hoglet67/TangNano20KDock/PiGPIO40.png

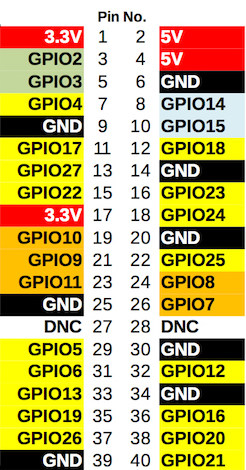
PiGPIO40.png
