hoglet67/TangNano20KDock/v1/tangnano20k_dock.pdf

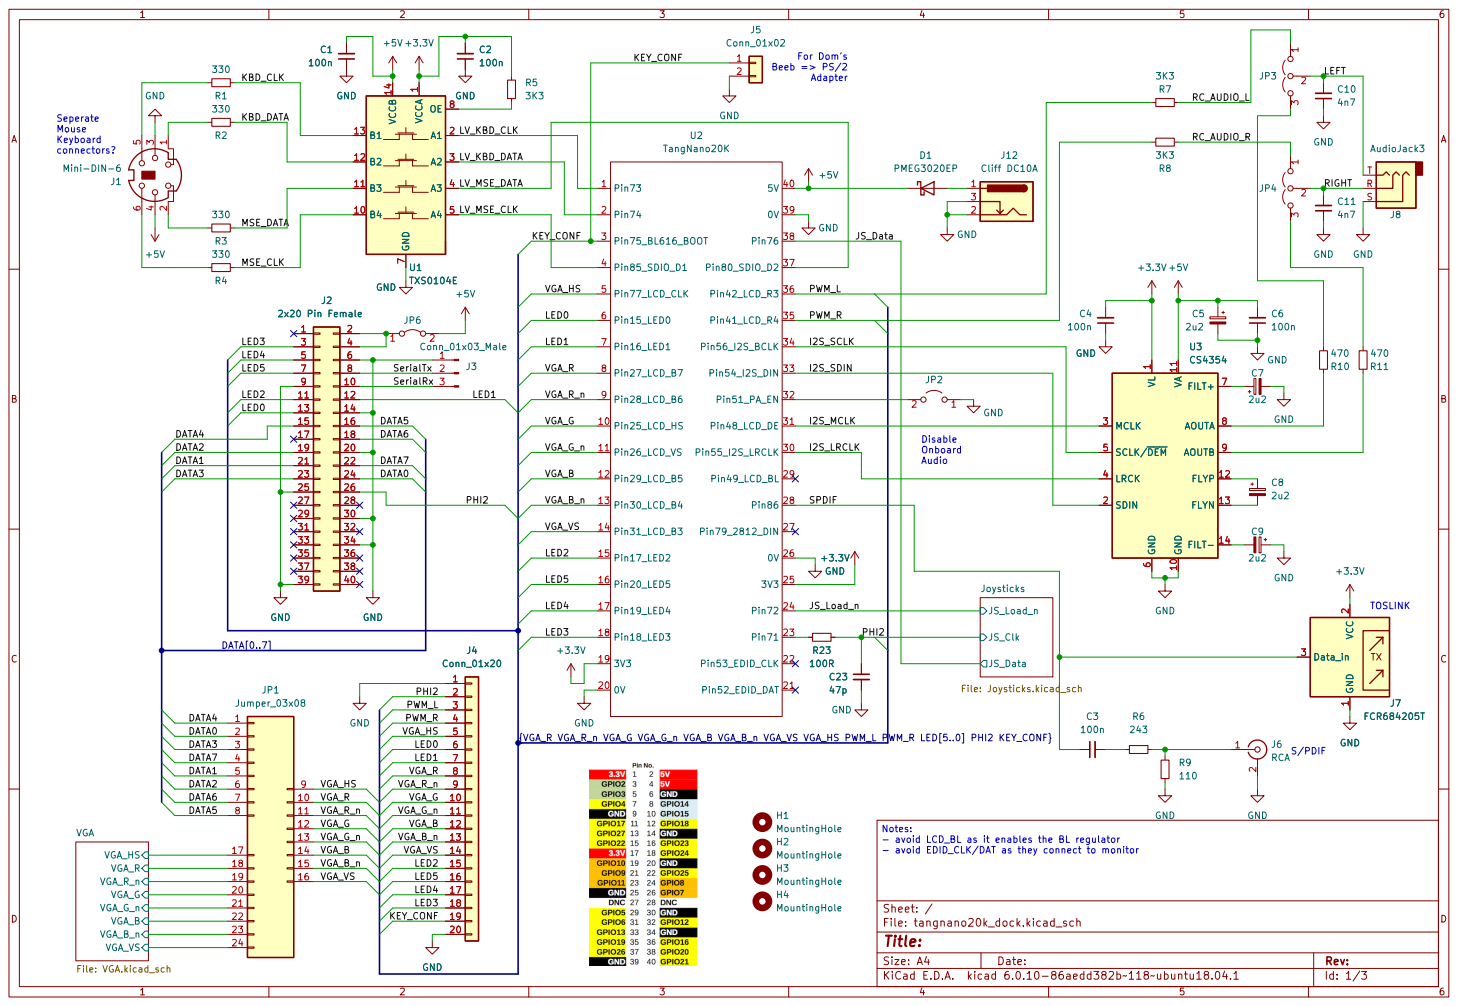
[picture p2: page 1]

For Dom's Beeb => PS/2 Adapter GND

I2S_SCLK

I2S_SDIN

1 GND 10 VA 11 FLYP 12 FLYN 13 FILT- 14 SDIN 2 MCLK 3

6 FILT+ 7 AOUTA 8 AOUTB 9 +3.3V GND

VGA_R_n VGA_B 12 VGA_G | 12 12
11 | 11 11
13 VGA_G_n | LED2 VGA_B VGA_B_n 13 13

18 | 15 VGA_B_n VGA_VS | 15 15
19 | 16 | 16 16
20 | | LED4 17 17

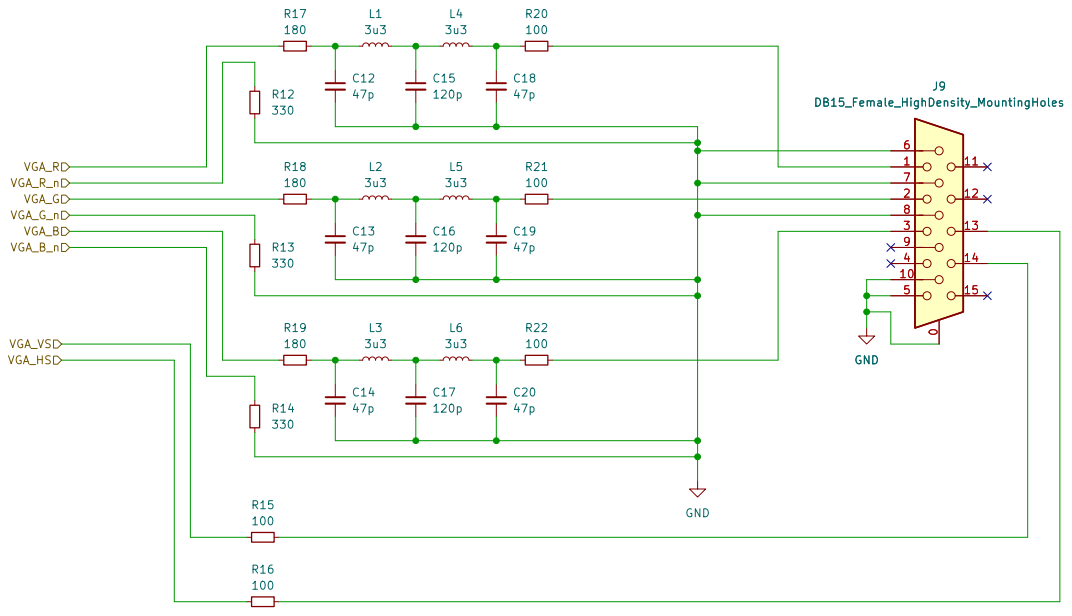
[picture p3: page 2]

File: VGA.kicad_sch Sheet: /VGA/
Id: 2/3 Title:

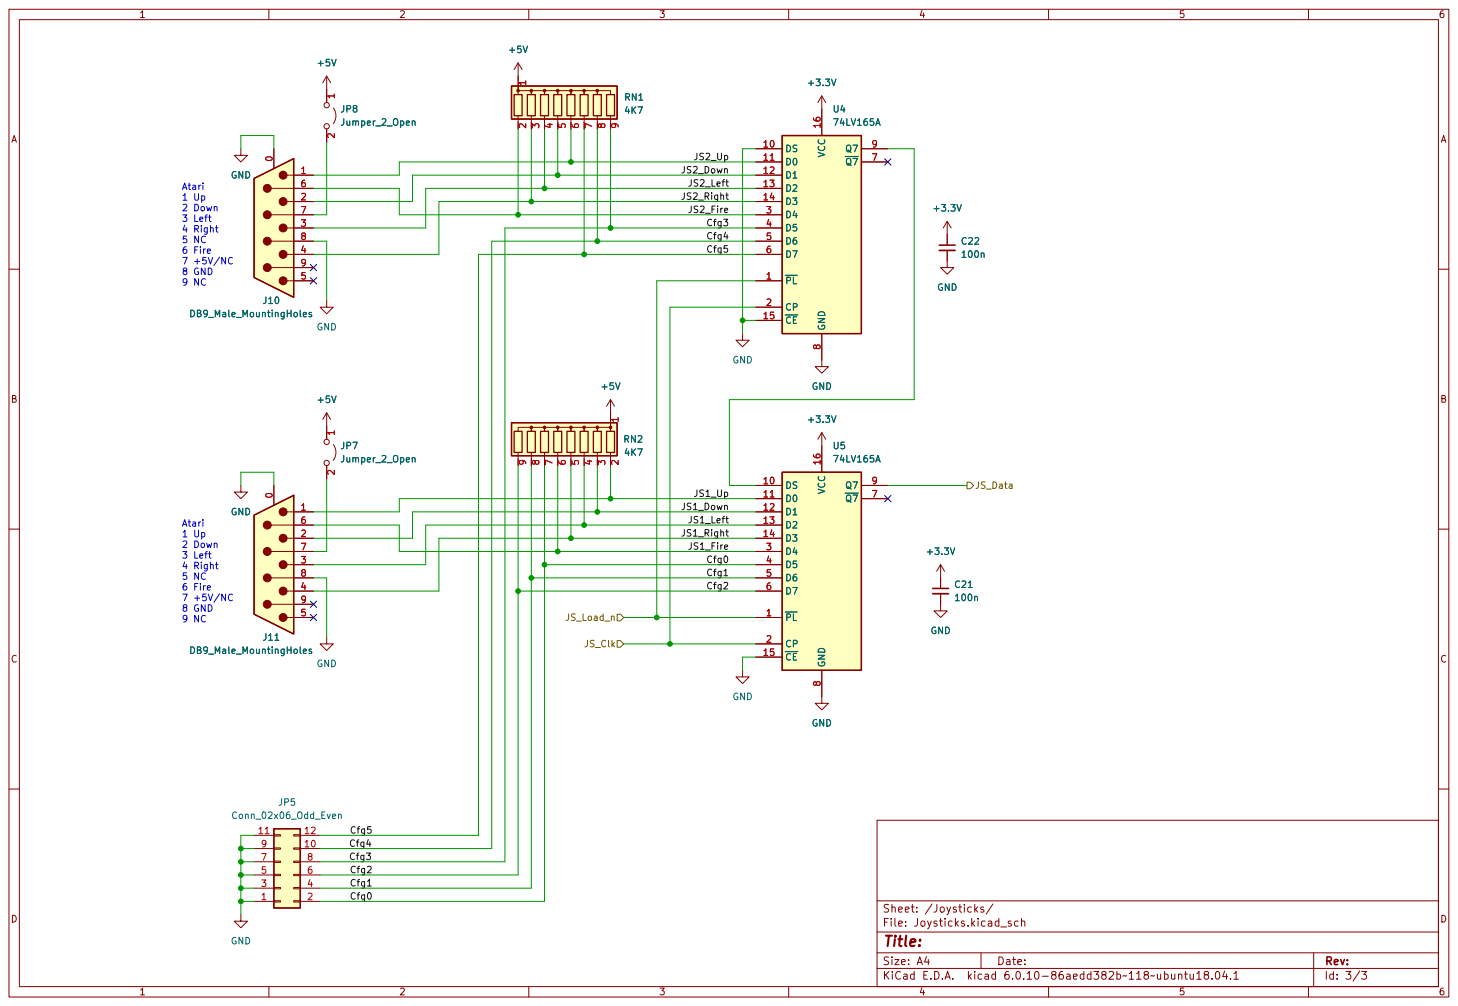
[picture p4: page 3]

JS1_Fire Atari 1 Up

Cfg0
Cfg1
