hoglet67/TangNano20KDock/v1/tangnano20k_dock.kicad_pcb

## KiCad design v1/tangnano20k_dock.kicad_pcb (2025-05-01)

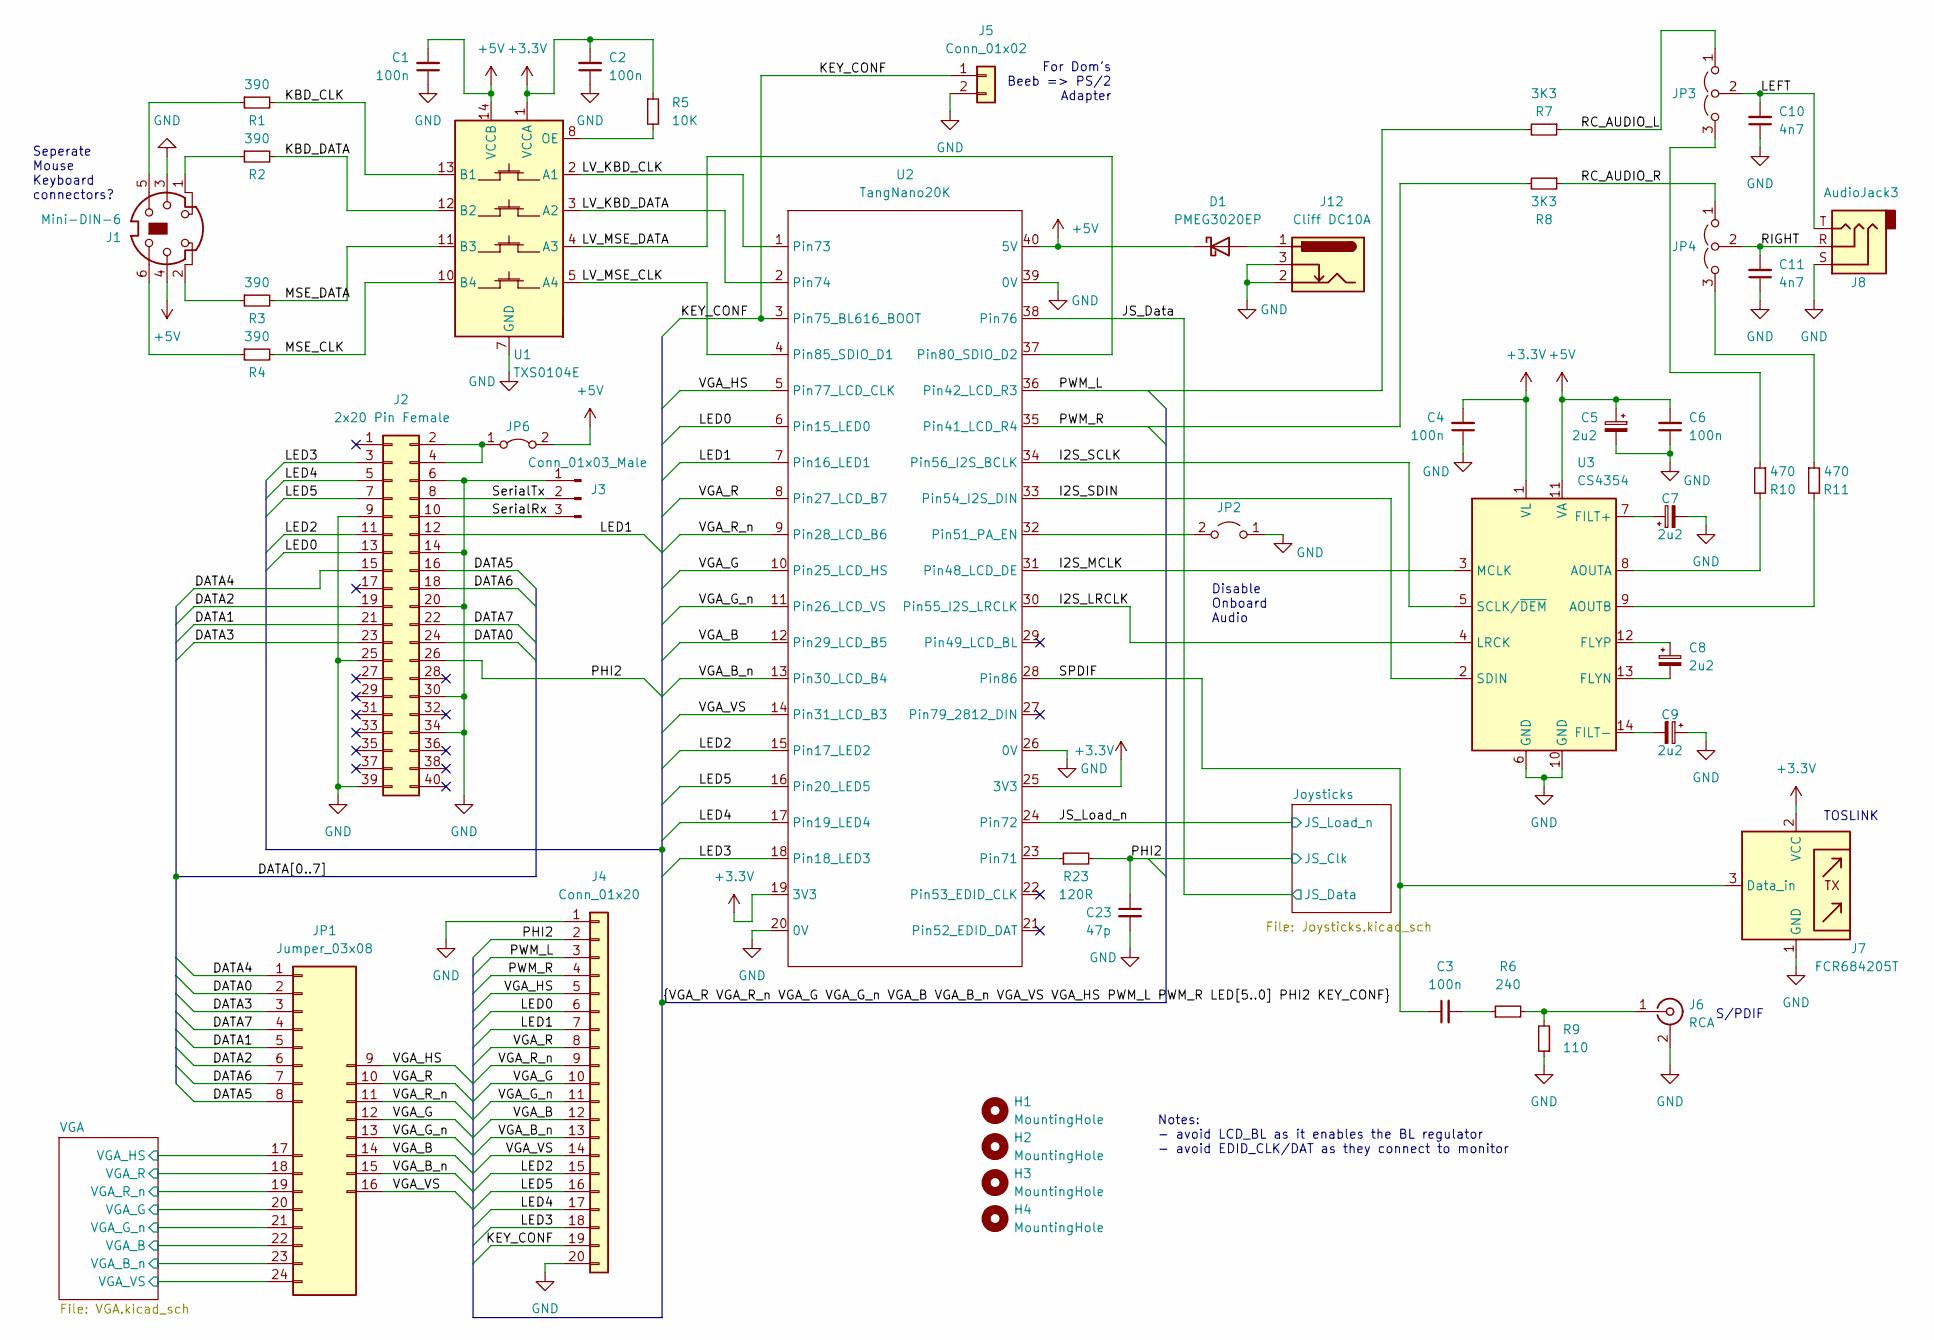
[picture p5: schematic tangnano20k_dock.kicad_sch]

Parts:
C1, C2, C3, C4, C6: 100n; C_1206_3216Metric_Pad1.33x1.80mm_HandSolder
C5, C7, C8, C9: 2u2; C_1206_3216Metric_Pad1.33x1.80mm_HandSolder
C10, C11: 4n7; C_1206_3216Metric_Pad1.33x1.80mm_HandSolder
C23: 47p; C_1206_3216Metric_Pad1.33x1.80mm_HandSolder
D1: PMEG3020EP; D_SOD-128
H1, H2, H3, H4: MountingHole; MountingHole_3.2mm_M3
J1: Mini-DIN-6; minidin6
J2: 2x20 Pin Female; Raspberry_Pi_Zero_Socketed_THT_FaceDown_MountingHoles
J3: Conn_01x03_Male; PinHeader_1x03_P2.54mm_Vertical
J4: Conn_01x20; PinHeader_1x20_P2.54mm_Vertical
J5: Conn_01x02; PinHeader_1x02_P2.54mm_Vertical
J6: RCA; phono
J7: FCR684205T
J8: AudioJack3; Jack_3.5mm_CUI_SJ1-3523N_Horizontal
J12: Cliff DC10A; CLIFF_FC68148_DC10A
JP1: Jumper_03x08; PinHeader_3x08_P2.54mm_Vertical
JP2: Jumper_2_Open; PinHeader_1x02_P2.54mm_Vertical
JP3, JP4: Jumper_3_Open; PinHeader_1x03_P2.54mm_Vertical
JP6: Jumper_2_Bridged; PinHeader_1x02_P2.54mm_Vertical
R1, R2, R3, R4: 390; R_1206_3216Metric_Pad1.30x1.75mm_HandSolder
R5: 10K; R_1206_3216Metric_Pad1.30x1.75mm_HandSolder
R6: 240; R_1206_3216Metric_Pad1.30x1.75mm_HandSolder
R7, R8: 3K3; R_1206_3216Metric_Pad1.30x1.75mm_HandSolder
R9: 110; R_1206_3216Metric_Pad1.30x1.75mm_HandSolder
R10, R11: 470; R_1206_3216Metric_Pad1.30x1.75mm_HandSolder
R23: 120R; R_1206_3216Metric_Pad1.30x1.75mm_HandSolder
U1: TXS0104E; SOIC-14_3.9x8.7mm_P1.27mm
U2: TangNano20K; TangNano20k
U3: CS4354; SOIC-14_3.9x8.7mm_P1.27mm

Connections:
+3.3V: C2.2, C4.2, J7.2 (VCC), R5.1, U1.1 (VCCA), U2.19 (3V3), U2.25 (3V3), U3.1 (VL); also elsewhere on the board
+5V: C1.2, C5.1, C6.2, D1.1 (K), J1.4, JP6.2 (B), U1.14 (VCCB), U2.40 (5V), U3.11 (VA); also elsewhere on the board
/DATA0: J2.24, JP1.2
/DATA1: J2.21, JP1.5
/DATA2: J2.19, JP1.6
/DATA3: J2.23, JP1.3
/DATA4: J2.15, JP1.1
/DATA5: J2.16, JP1.8
/DATA6: J2.18, JP1.7
/DATA7: J2.22, JP1.4
/I2S_LRCLK: U2.30 (Pin55_I2S_LRCLK), U3.4 (LRCK)
/I2S_MCLK: U2.31 (Pin48_LCD_DE), U3.3 (MCLK)
/I2S_SCLK: U2.34 (Pin56_I2S_BCLK), U3.5 (SCLK/~DEM)
/I2S_SDIN: U2.33 (Pin54_I2S_DIN), U3.2 (SDIN)
/JS_Data: U2.38 (Pin76); also elsewhere on the board
/JS_Load_n: U2.24 (Pin72); also elsewhere on the board
/KBD_CLK: R1.2, U1.13 (B1)
/KBD_DATA: R2.2, U1.12 (B2)
/KEY_CONF: J4.19, J5.1, U2.3 (Pin75_BL616_BOOT)
/LED0: J2.13, J4.6, U2.6 (Pin15_LED0)
/LED1: J2.12, J4.7, U2.7 (Pin16_LED1)
/LED2: J2.11, J4.15, U2.15 (Pin17_LED2)
/LED3: J2.3, J4.18, U2.18 (Pin18_LED3)
/LED4: J2.5, J4.17, U2.17 (Pin19_LED4)
/LED5: J2.7, J4.16, U2.16 (Pin20_LED5)
/LEFT: C10.2, J8.T, JP3.2 (C)
/LV_KBD_CLK: U1.2 (A1), U2.1 (Pin73)
/LV_KBD_DATA: U1.3 (A2), U2.2 (Pin74)
/LV_MSE_CLK: U1.5 (A4), U2.4 (Pin85_SDIO_D1)
/LV_MSE_DATA: U1.4 (A3), U2.37 (Pin80_SDIO_D2)
/MSE_CLK: R4.2, U1.10 (B4)
/MSE_DATA: R3.2, U1.11 (B3)
/PHI2: C23.1, J2.26, J4.2, R23.2; also elsewhere on the board
/PWM_L: J4.3, R7.2, U2.36 (Pin42_LCD_R3)
/PWM_R: J4.4, R8.2, U2.35 (Pin41_LCD_R4)
/RC_AUDIO_L: JP3.1 (A), R7.1
/RC_AUDIO_R: JP4.1 (A), R8.1
/RIGHT: C11.2, J8.R, JP4.2 (C)
/SPDIF: C3.1, J7.3 (Data_in), U2.28 (Pin86)
/SerialRx: J2.10, J3.3
/SerialTx: J2.8, J3.2
/VGA/VGA_B: JP1.22; also elsewhere on the board
/VGA/VGA_B_n: JP1.23; also elsewhere on the board
/VGA/VGA_G: JP1.20; also elsewhere on the board
/VGA/VGA_G_n: JP1.21; also elsewhere on the board
/VGA/VGA_HS: JP1.17; also elsewhere on the board
/VGA/VGA_R: JP1.18; also elsewhere on the board
/VGA/VGA_R_n: JP1.19; also elsewhere on the board
/VGA/VGA_VS: JP1.24; also elsewhere on the board
/VGA_B: J4.12, JP1.14, U2.12 (Pin29_LCD_B5)
/VGA_B_n: J4.13, JP1.15, U2.13 (Pin30_LCD_B4)
/VGA_G: J4.10, JP1.12, U2.10 (Pin25_LCD_HS)
/VGA_G_n: J4.11, JP1.13, U2.11 (Pin26_LCD_VS)
/VGA_HS: J4.5, JP1.9, U2.5 (Pin77_LCD_CLK)
/VGA_R: J4.8, JP1.10, U2.8 (Pin27_LCD_B7)
/VGA_R_n: J4.9, JP1.11, U2.9 (Pin28_LCD_B6)
/VGA_VS: J4.14, JP1.16, U2.14 (Pin31_LCD_B3)
GND: C1.1, C2.1, C4.1, C5.2, C6.1, C7.2, C9.1, C10.1, C11.1, C23.2, J1.3, J2.6, J2.9, J2.14, J2.20, J2.25, J2.30, J2.34, J2.39, J3.1, J4.1, J4.20, J5.2, J6.2 (Ext), J7.1 (GND), J8.S, J12.2, J12.3, JP2.1 (A), R9.1, U1.7 (GND), U2.20 (0V), U2.26 (0V), U2.39 (0V), U3.6 (GND), U3.10 (GND); also elsewhere on the board
unnamed: C3.2, R6.1
unnamed: C7.1, U3.7 (FILT+)
unnamed: C8.1, U3.12 (FLYP)
unnamed: C8.2, U3.13 (FLYN)
unnamed: C9.2, U3.14 (FILT-)
unnamed: D1.2 (A), J12.1
unnamed: J1.1, R2.1
unnamed: J1.2, R3.1
unnamed: J1.5, R1.1
unnamed: J1.6, R4.1
unnamed: J2.2, J2.4, JP6.1 (A)
unnamed: J6.1 (In), R6.2, R9.2
unnamed: JP2.2 (B), U2.32 (Pin51_PA_EN)
unnamed: JP3.3 (B), R10.1
unnamed: JP4.3 (B), R11.1
unnamed: R5.2, U1.8 (OE)
unnamed: R10.2, U3.8 (AOUTA)
unnamed: R11.2, U3.9 (AOUTB)
unnamed: R23.1, U2.23 (Pin71)

Notes on the sheet:
Seperate Mouse Keyboard connectors?
TOSLINK
S/PDIF
Notes: - avoid LCD_BL as it enables the BL regulator - avoid EDID_CLK/DAT as they connect to monitor
For Dom's Beeb => PS/2 Adapter
Disable Onboard Audio

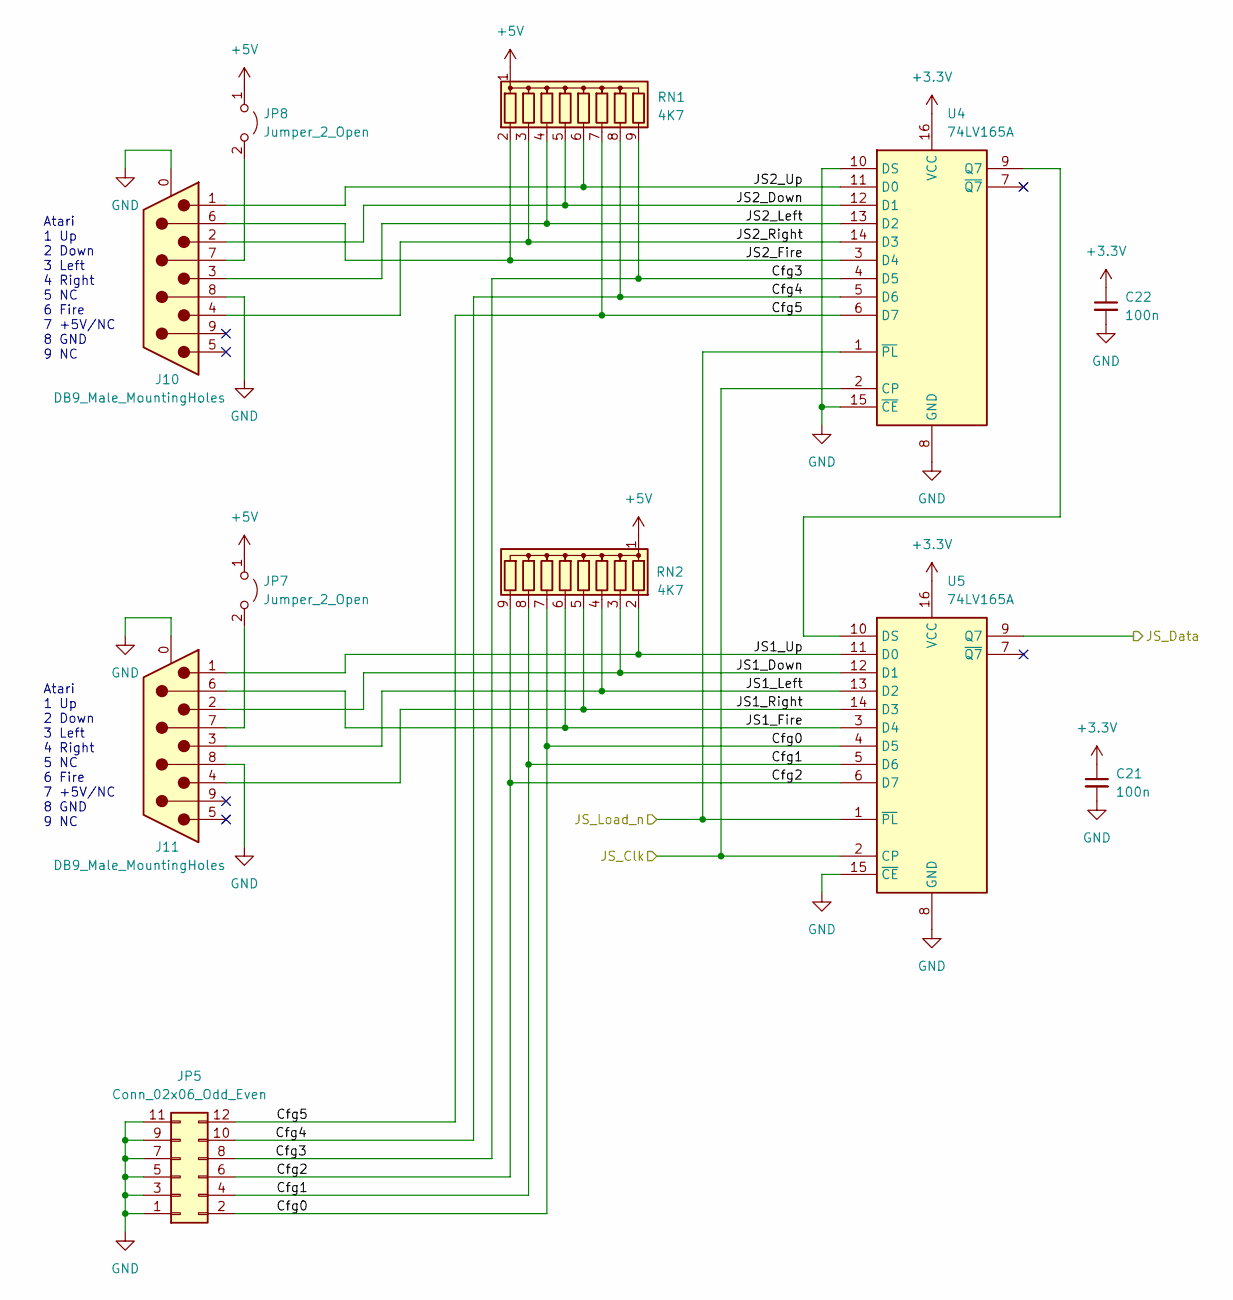
[picture p6: schematic Joysticks.kicad_sch]

Parts:
C21, C22: 100n; C_1206_3216Metric_Pad1.33x1.80mm_HandSolder
J10, J11: DB9_Male_MountingHoles; DSUB-9_Male_Horizontal_P2.77x2.84mm_EdgePinOffset7.70mm_Hou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
JP5: Conn_02x06_Odd_Even; PinHeader_2x06_P2.54mm_Vertical
JP7, JP8: Jumper_2_Open; PinHeader_1x02_P2.54mm_Vertical
RN1, RN2: 4K7; R_Array_SIP9
U4, U5: 74LV165A; SOIC-16_3.9x9.9mm_P1.27mm

Connections:
+3.3V: C21.1, C22.1, U4.16 (VCC), U5.16 (VCC); also elsewhere on the board
+5V: JP7.1 (A), JP8.1 (A), RN1.1 (common), RN2.1 (common); also elsewhere on the board
/JS_Data: U5.9 (Q7); also elsewhere on the board
/JS_Load_n: U4.1 (~PL), U5.1 (~PL); also elsewhere on the board
/Joysticks/Cfg0: JP5.2, RN2.7 (R6), U5.4 (D5)
/Joysticks/Cfg1: JP5.4, RN2.8 (R7), U5.5 (D6)
/Joysticks/Cfg2: JP5.6, RN2.9 (R8), U5.6 (D7)
/Joysticks/Cfg3: JP5.8, RN1.9 (R8), U4.4 (D5)
/Joysticks/Cfg4: JP5.10, RN1.8 (R7), U4.5 (D6)
/Joysticks/Cfg5: JP5.12, RN1.7 (R6), U4.6 (D7)
/Joysticks/JS1_Down: J11.2, RN2.3 (R2), U5.12 (D1)
/Joysticks/JS1_Fire: J11.6, RN2.6 (R5), U5.3 (D4)
/Joysticks/JS1_Left: J11.3, RN2.4 (R3), U5.13 (D2)
/Joysticks/JS1_Right: J11.4, RN2.5 (R4), U5.14 (D3)
/Joysticks/JS1_Up: J11.1, RN2.2 (R1), U5.11 (D0)
/Joysticks/JS2_Down: J10.2, RN1.5 (R4), U4.12 (D1)
/Joysticks/JS2_Fire: J10.6, RN1.2 (R1), U4.3 (D4)
/Joysticks/JS2_Left: J10.3, RN1.4 (R3), U4.13 (D2)
/Joysticks/JS2_Right: J10.4, RN1.3 (R2), U4.14 (D3)
/Joysticks/JS2_Up: J10.1, RN1.6 (R5), U4.11 (D0)
/PHI2: U4.2 (CP), U5.2 (CP); also elsewhere on the board
GND: C21.2, C22.2, J10.0 (PAD), J10.8, J11.0 (PAD), J11.8, JP5.1, JP5.3, JP5.5, JP5.7, JP5.9, JP5.11, U4.8 (GND), U4.10 (DS), U4.15 (~CE), U5.8 (GND), U5.15 (~CE); also elsewhere on the board
unnamed: J10.7, JP8.2 (B)
unnamed: J11.7, JP7.2 (B)
unnamed: U4.9 (Q7), U5.10 (DS)

Notes on the sheet:
Atari 1 Up 2 Down 3 Left 4 Right 5 NC 6 Fire 7 +5V/NC 8 GND 9 NC

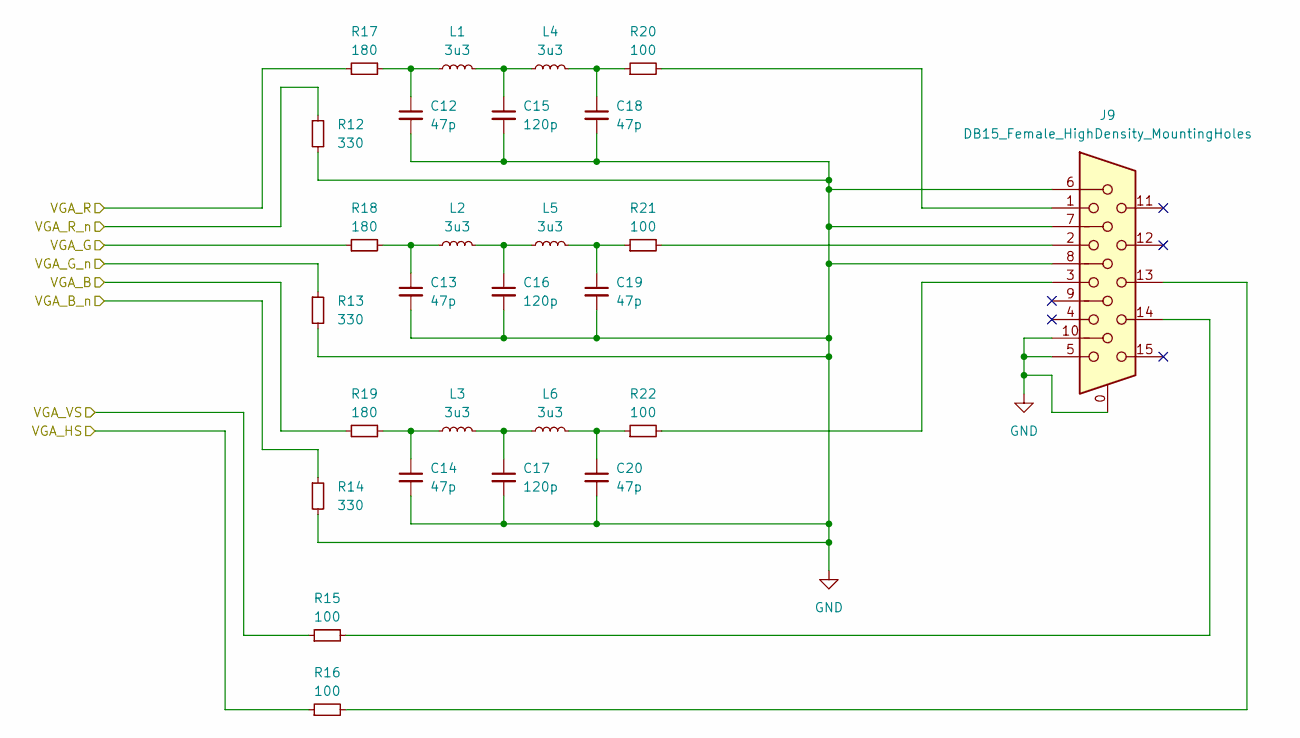
[picture p7: schematic VGA.kicad_sch]

Parts:
C12, C13, C14, C18, C19, C20: 47p; C_1206_3216Metric_Pad1.33x1.80mm_HandSolder
C15, C16, C17: 120p; C_1206_3216Metric_Pad1.33x1.80mm_HandSolder
J9: DB15_Female_HighDensity_MountingHoles; DSUB-15-HD_Female_Horizontal_P2.29x1.98mm_EdgePinOffset8.35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
L1, L2, L3, L4, L5, L6: 3u3; L_1206_3216Metric_Pad1.42x1.75mm_HandSolder
R12, R13, R14: 330; R_1206_3216Metric_Pad1.30x1.75mm_HandSolder
R15, R16, R20, R21, R22: 100; R_1206_3216Metric_Pad1.30x1.75mm_HandSolder
R17, R18, R19: 180; R_1206_3216Metric_Pad1.30x1.75mm_HandSolder

Connections:
/VGA/VGA_B: R19.1; also elsewhere on the board
/VGA/VGA_B_n: R14.1; also elsewhere on the board
/VGA/VGA_G: R18.1; also elsewhere on the board
/VGA/VGA_G_n: R13.1; also elsewhere on the board
/VGA/VGA_HS: R16.1; also elsewhere on the board
/VGA/VGA_R: R17.1; also elsewhere on the board
/VGA/VGA_R_n: R12.1; also elsewhere on the board
/VGA/VGA_VS: R15.1; also elsewhere on the board
GND: C12.2, C13.2, C14.2, C15.2, C16.2, C17.2, C18.2, C19.2, C20.2, J9.0, J9.5, J9.6, J9.7, J9.8, J9.10, R12.2, R13.2, R14.2; also elsewhere on the board
unnamed: C12.1, L1.1, R17.2
unnamed: C13.1, L2.1, R18.2
unnamed: C14.1, L3.1, R19.2
unnamed: C15.1, L1.2, L4.1
unnamed: C16.1, L2.2, L5.1
unnamed: C17.1, L3.2, L6.1
unnamed: C18.1, L4.2, R20.1
unnamed: C19.1, L5.2, R21.1
unnamed: C20.1, L6.2, R22.1
unnamed: J9.1, R20.2
unnamed: J9.2, R21.2
unnamed: J9.3, R22.2
unnamed: J9.13, R16.2
unnamed: J9.14, R15.2

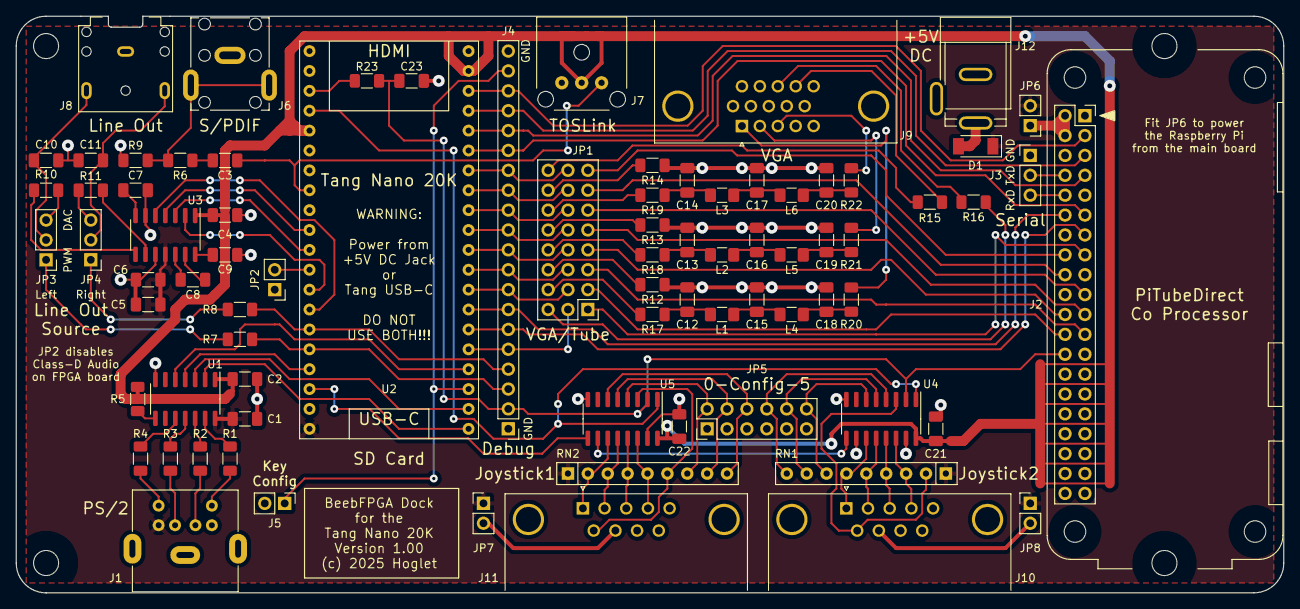
[picture p8: board tangnano20k_dock.kicad_pcb from above]

Board: 2 copper layers, 161.9 x 73.7 mm, 84 parts (0 on the bottom side), 110 nets.
