hoglet67/TangNano20KDock/v1/AssemblyListPassives.ods

Tang Nano 20K Dock v1.00 SMT Passives BOM
# Boards | 3 | per board | total | supplied (+10%+3)
Resistors
0R | R23 | 1 | 3 | 7
100R | R15-16,R20-22 | 5 | 15 | 20
110R | R9 | 1 | 3 | 7
180R | R17-19 | 3 | 9 | 13
243R | R6 | 1 | 3 | 7
330R | R1-4,R12-14 | 7 | 21 | 27
470R | R10-11 | 2 | 6 | 10
3K3 | R5,R7-8 | 3 | 9 | 13
Capacitors
NF | C23
47p | C12-14,C18-20 | 6 | 18 | 23
120p | C15-17 | 3 | 9 | 13
4n7 | C10-11 | 2 | 6 | 10
100n | C1-4,C6,C21-22 | 7 | 21 | 27
2u2 | C5,C7-9 | 4 | 12 | 17
Inductors
3u3 | L1-6 | 6 | 18 | 23
