hoglet67/TangNano20KDock/(commit log)

2025-02-22 Everything connected
    [tangnano20k_dock.kicad_pcb, tangnano20k_dock.kicad_sch]
2025-02-23 Much tidying up, corrected VGA footprint
    [tangnano20k_dock.kicad_pcb, tangnano20k_dock.kicad_sch]
2025-02-23 Corrected Joystick footprint
    [tangnano20k_dock.kicad_pcb, tangnano20k_dock.kicad_sch]
2025-02-23 Re-orient resistors
    [tangnano20k_dock.kicad_pcb]
2025-02-24 Silk screen only
    [tangnano20k_dock.kicad_pcb]
2025-02-24 Refresh PDF schematic
2025-04-26 Minor changes
    [tangnano20k_dock.kicad_pcb, tangnano20k_dock.kicad_sch]
2025-04-26 Start again, using 1206 SMT
    [tangnano20k_dock.kicad_pcb, tangnano20k_dock.kicad_sch]
2025-04-27 Work in progress
    [Joysticks.kicad_sch, VGA.kicad_sch, tangnano20k_dock.kicad_pcb, tangnano20k_dock.kicad_sch]
2025-04-27 Fully routed and passes DRC
    [tangnano20k_dock.kicad_pcb]
2025-04-27 Silk screen
    [tangnano20k_dock.kicad_pcb]
2025-04-28 Added rounded corners
    [tangnano20k_dock.kicad_pcb]
2025-04-28 Updated VGA jumper block from 2x6 to 3x6
    [VGA.kicad_sch, tangnano20k_dock.kicad_pcb, tangnano20k_dock.kicad_sch]
2025-04-28 Updated VGA jumper block from 3x6 to 3x8
    [Joysticks.kicad_sch, VGA.kicad_sch, tangnano20k_dock.kicad_pcb, tangnano20k_dock.kicad_sch]
2025-04-28 Spread out VGA filter passives
    [tangnano20k_dock.kicad_pcb]
2025-04-28 Spread out audio passives
    [tangnano20k_dock.kicad_pcb]
2025-04-28 Corrected error in PS/2 footprint
    [tangnano20k_dock.kicad_pcb]
2025-04-28 Silk-screen and swap PWM L/R labels
    [tangnano20k_dock.kicad_pcb, tangnano20k_dock.kicad_sch]
2025-04-28 Added jumpers for Pi and Joystick power
    [Joysticks.kicad_sch, tangnano20k_dock.kicad_pcb, tangnano20k_dock.kicad_sch]
2025-04-29 Hacked in some 3D models for custom footprints
    [tangnano20k_dock.kicad_pcb]
2025-04-29 Switched to Cliffe FC68131 Jack (matches CUI_SJ1-3523N footprint)
    [tangnano20k_dock.kicad_pcb, tangnano20k_dock.kicad_sch]
2025-04-29 Add 3D model for 3.5mm Jack
    [tangnano20k_dock.kicad_pcb]
2025-04-29 Switched to Pro Signal PSG01547 for Phono
    [tangnano20k_dock.kicad_pcb]
2025-04-29 Added optional mounting holes for phono
    [tangnano20k_dock.kicad_pcb]
2025-04-29 Add 3D model for FCR684205T optical transmitter
    [tangnano20k_dock.kicad_pcb]
2025-04-29 Extend board to allow mounting holes for Raspberry Pi
    [tangnano20k_dock.kicad_pcb, tangnano20k_dock.kicad_sch]
2025-04-29 Make mounting holes orthogonal
    [tangnano20k_dock.kicad_pcb]
2025-04-29 Tweaked power routing around Pi
    [tangnano20k_dock.kicad_pcb]
2025-04-29 Move R15/16 a bit
    [tangnano20k_dock.kicad_pcb]
2025-04-29 Tidy around Joystick connectors
    [Joysticks.kicad_sch, tangnano20k_dock.kicad_pcb]
2025-04-29 Nudge J4 and JP1 over slightly
    [tangnano20k_dock.kicad_pcb]
2025-04-29 Add clearance around mounting holes
    [tangnano20k_dock.kicad_pcb, tangnano20k_dock.kicad_sch]
2025-04-29 Add 2x20 3D model to Pi footprint
    [tangnano20k_dock.kicad_pcb]
2025-04-30 Drive PiTube PHI2 from WS2812 output, freeing up PWM
    [tangnano20k_dock.kicad_pcb, tangnano20k_dock.kicad_sch]
2025-04-30 Correct swapped net names LED3 and LED5
    [tangnano20k_dock.kicad_pcb, tangnano20k_dock.kicad_sch]
2025-04-30 Add KEY_CONF to DEBUG header
    [tangnano20k_dock.kicad_pcb, tangnano20k_dock.kicad_sch]
2025-04-30 Drive PiTube PHI2 from js_clk to save a pin
    [tangnano20k_dock.kicad_pcb, tangnano20k_dock.kicad_sch]
2025-04-30 Add an RC filter to allow PHI2 clock edge to be slowed to avoid ringing
    [tangnano20k_dock.kicad_pcb, tangnano20k_dock.kicad_sch]
2025-05-01 Added Cliff DC10A power jack + schottky diode
    [tangnano20k_dock.kicad_pcb, tangnano20k_dock.kicad_sch]
2025-05-01 Beef up longer 5V tracks
    [tangnano20k_dock.kicad_pcb]
2025-05-01 Added 3D model for SOD128 diode
    [tangnano20k_dock.kicad_pcb]
2025-05-01 Address some DFM issues
    [tangnano20k_dock.kicad_pcb]
2025-05-01 More minor DFM issues
    [tangnano20k_dock.kicad_pcb, tangnano20k_dock.kicad_sch]
2025-05-01 Re-layout VGA filter + used 5V plane
    [tangnano20k_dock.kicad_pcb]
2025-05-01 Tweak routing around +5V into Nano
    [tangnano20k_dock.kicad_pcb]
2025-05-01 Double up on the VGA filter GND vias
    [tangnano20k_dock.kicad_pcb]
2025-05-01 Added manufacturing files
    [tangnano20k_dock-B_Cu.gbl, tangnano20k_dock-B_Mask.gbs, tangnano20k_dock-B_Paste.gbp, tangnano20k_dock-B_Silkscreen.gbo, tangnano20k_dock-Edge_Cuts.gm1, tangnano20k_dock-F_Cu.gtl, tangnano20k_dock-F_Mask.gts, tangnano20k_dock-F_Paste.gtp]
2025-05-04 Update resistor values and refresh PDF
    [tangnano20k_dock.kicad_sch]
2025-05-15 Added SMT Passive assembly notes
    [AssemblyListPassives.ods]
2025-05-15 Added errara for v1.00 PCB
2025-05-16 Updated errara for v1.00 PCB
