hoglet67/TangNano20KDock/(notices)

Notices in the files:
v1/tangnano20k_dock.kicad_pcb:
(c) 2025 Hoglet
